imgeorgiev/SDP_G19_OfficeBot/Docs/sdp_new_environment_mockup.png

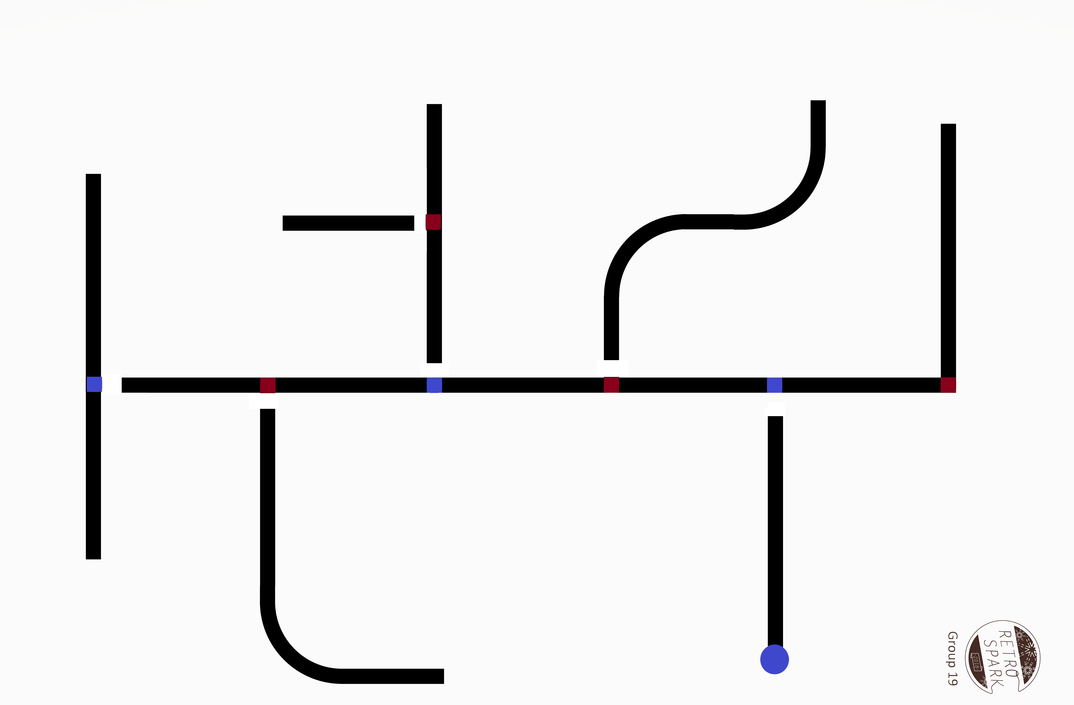
Docs/sdp_new_environment_mockup.png
