imgeorgiev/SDP_G19_OfficeBot/rpi/webapp/line2.jpg

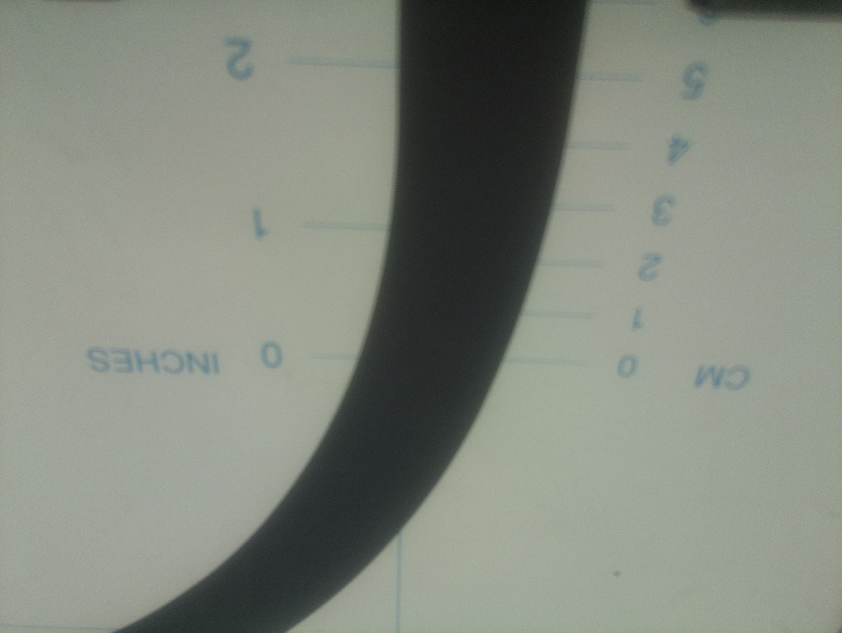
rpi/webapp/line2.jpg
