imgeorgiev/SDP_G19_OfficeBot/rpi/webapp/out.jpg

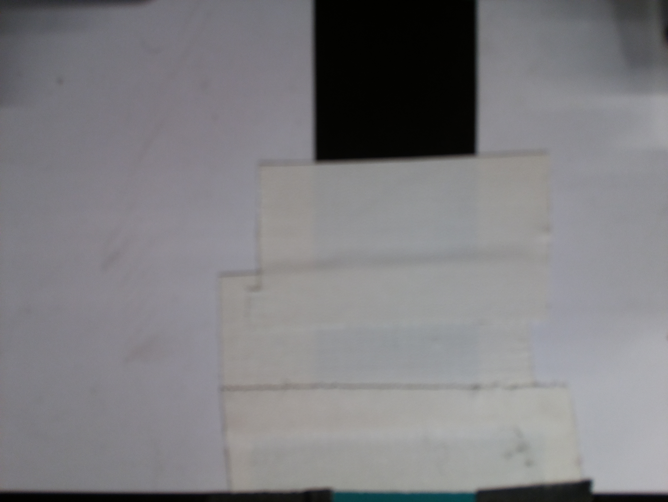
rpi/webapp/out.jpg
