imgeorgiev/SDP_G19_OfficeBot/rpi/webapp/paths2.jpg

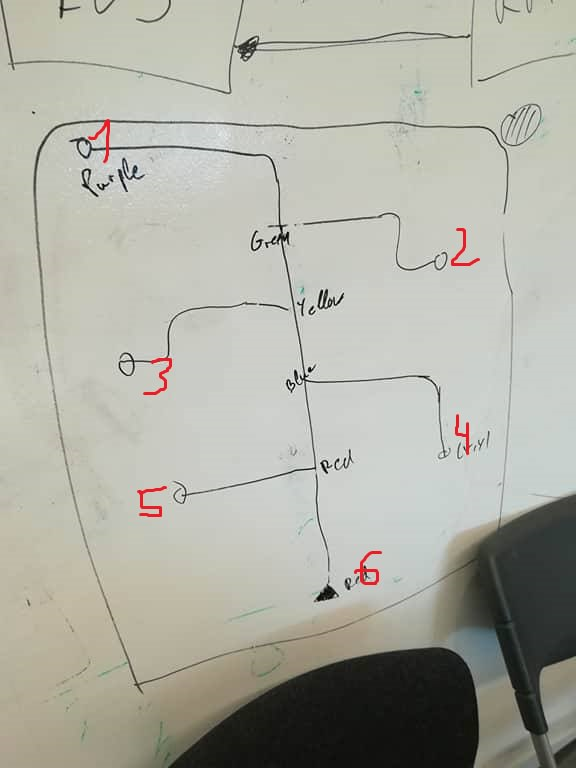
rpi/webapp/paths2.jpg
