imgeorgiev/SDP_G19_OfficeBot/rpi/webapp/paths2.png

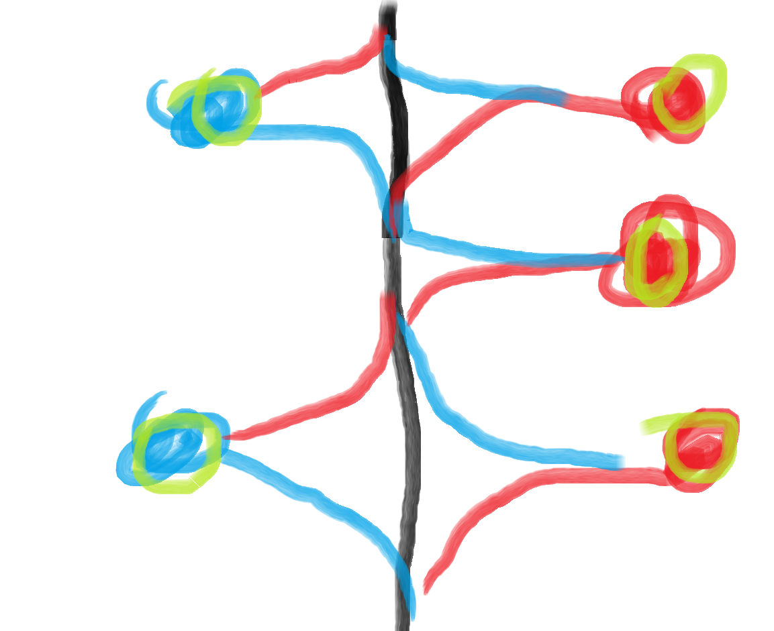
rpi/webapp/paths2.png
