imgeorgiev/SDP_G19_OfficeBot/rpi/webapp/paths.jpg

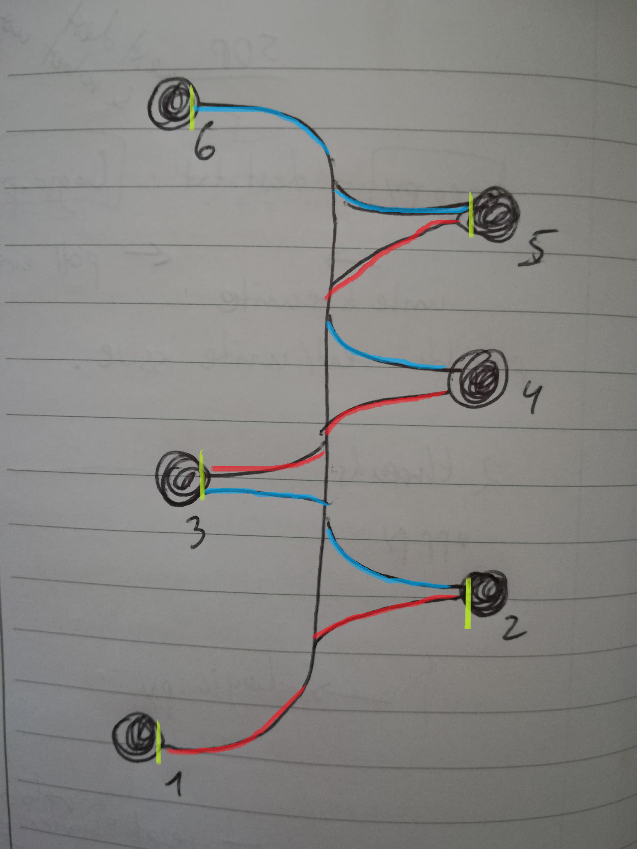
rpi/webapp/paths.jpg
