imgeorgiev/SDP_G19_OfficeBot/rpi/webapp/photos/blue.jpg

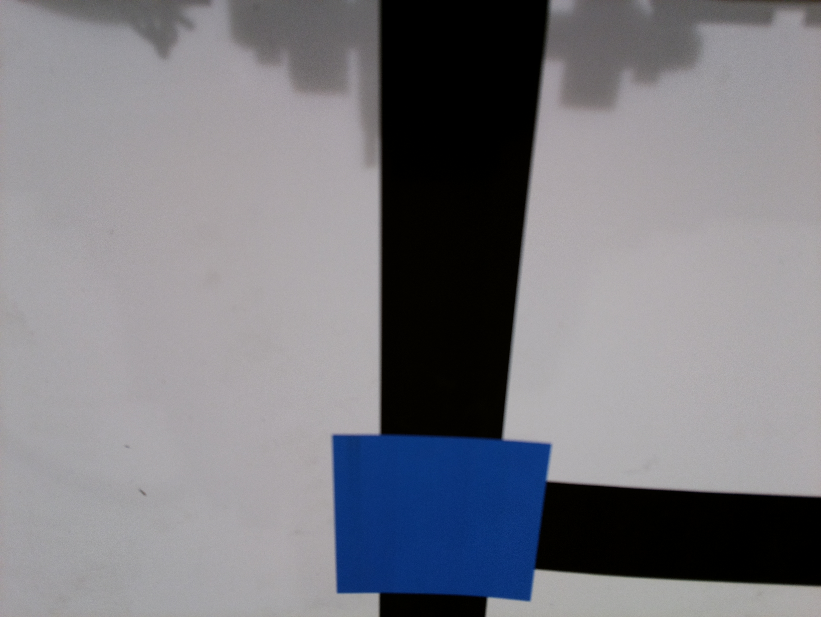
rpi/webapp/photos/blue.jpg
