imgeorgiev/SDP_G19_OfficeBot/rpi/webapp/photos/green.jpg

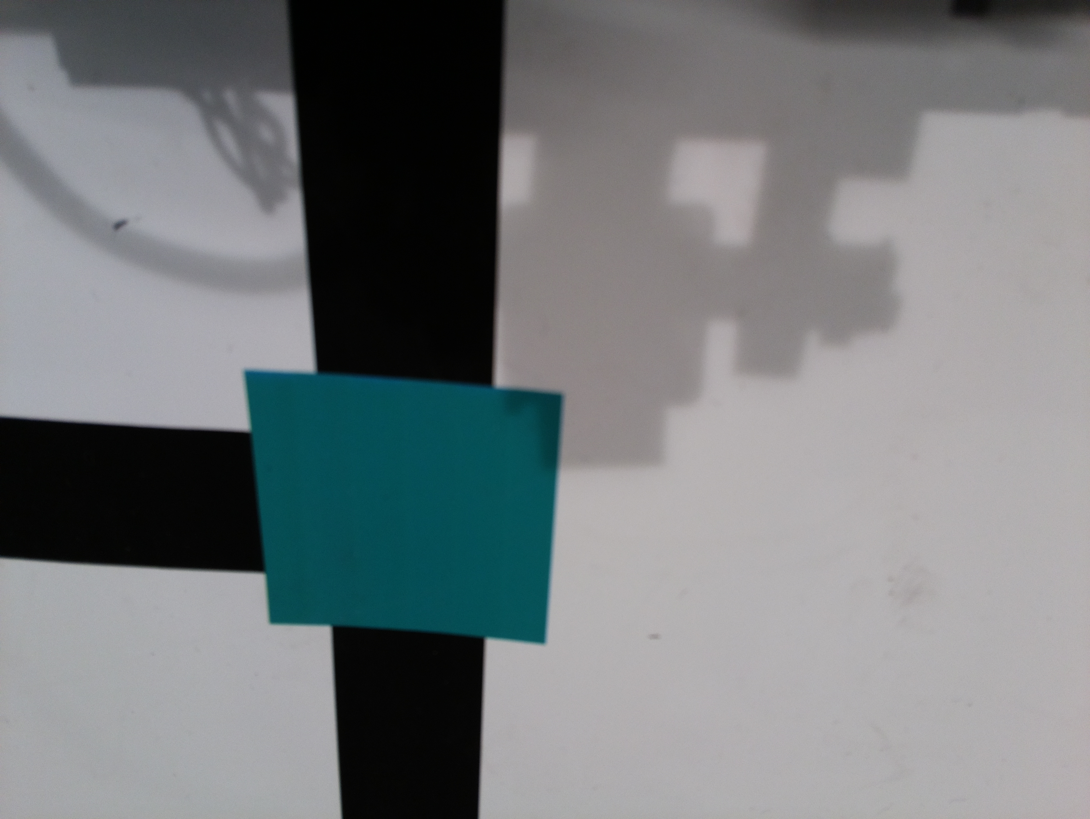
rpi/webapp/photos/green.jpg
