imgeorgiev/SDP_G19_OfficeBot/rpi/webapp/photos/grey.jpg

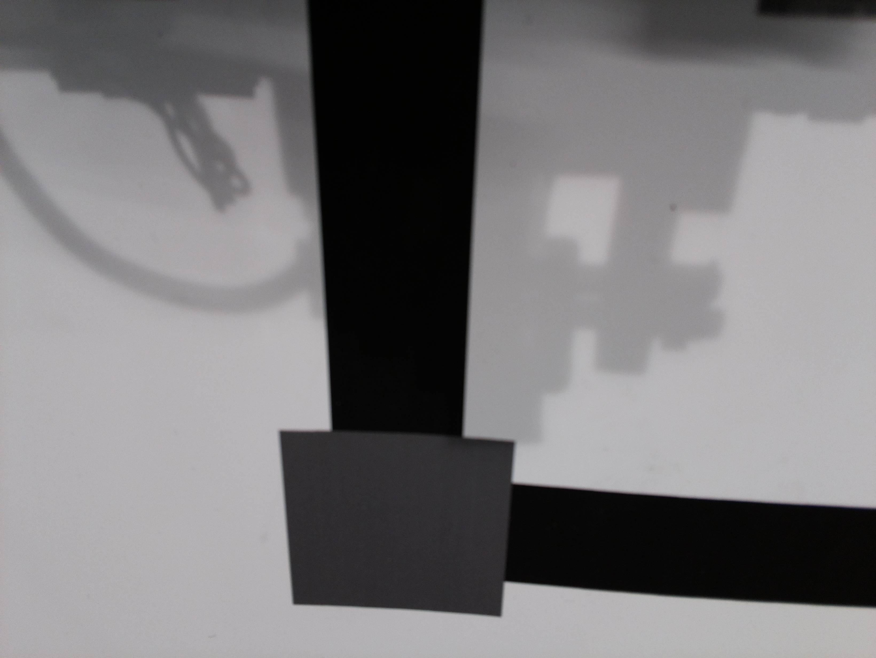
rpi/webapp/photos/grey.jpg
