imgeorgiev/SDP_G19_OfficeBot/rpi/webapp/photos/orange.jpg

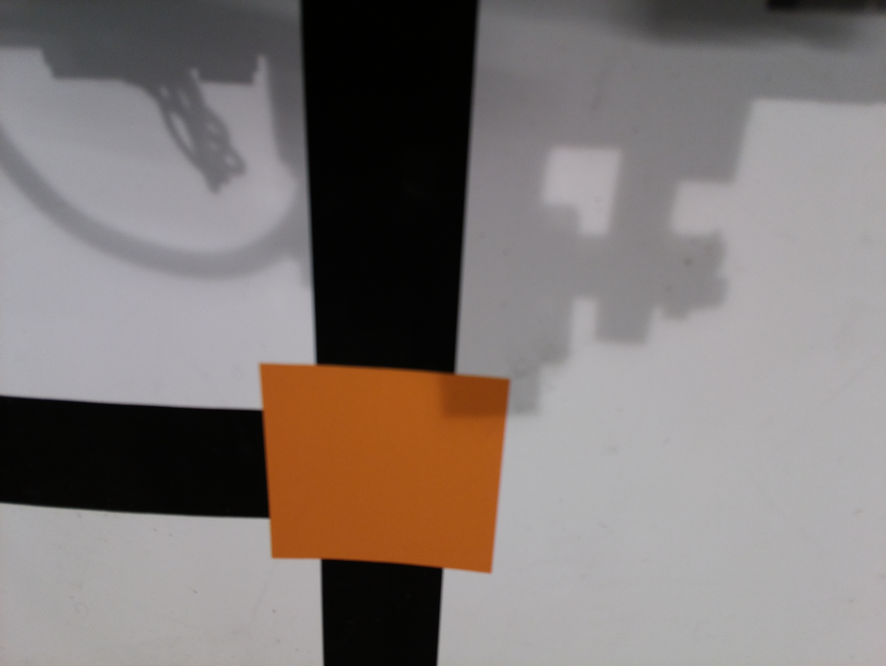
rpi/webapp/photos/orange.jpg
