imgeorgiev/SDP_G19_OfficeBot/rpi/webapp/photos/pink.jpg

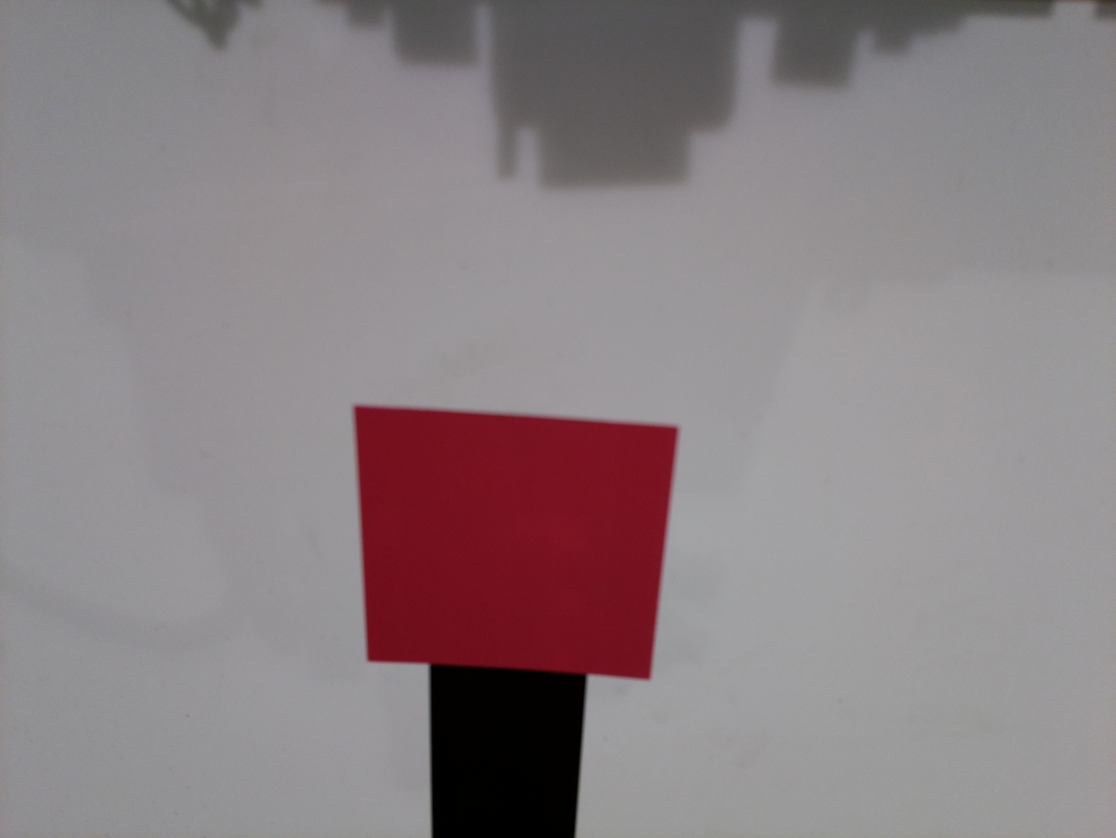
rpi/webapp/photos/pink.jpg
