imgeorgiev/SDP_G19_OfficeBot/rpi/webapp/photos/purple.jpg

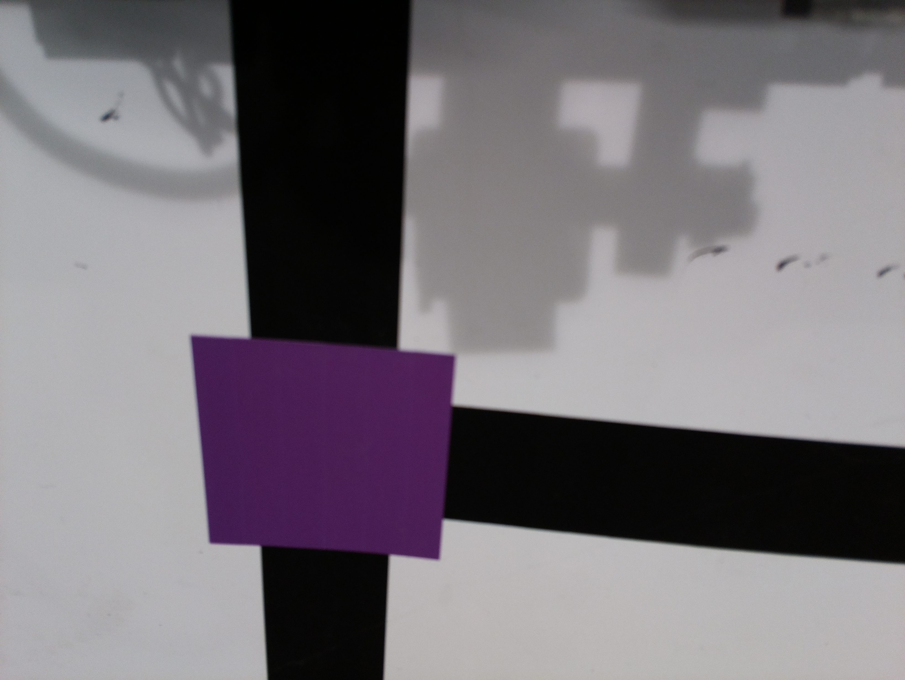
rpi/webapp/photos/purple.jpg
