imgeorgiev/SDP_G19_OfficeBot/rpi/webapp/photos/red.jpg

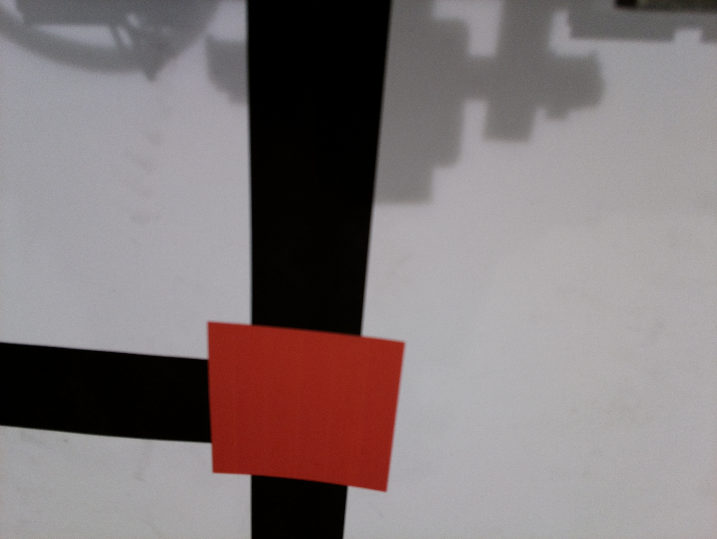
rpi/webapp/photos/red.jpg
