imgeorgiev/SDP_G19_OfficeBot/rpi/webapp/photos/yellow.jpg

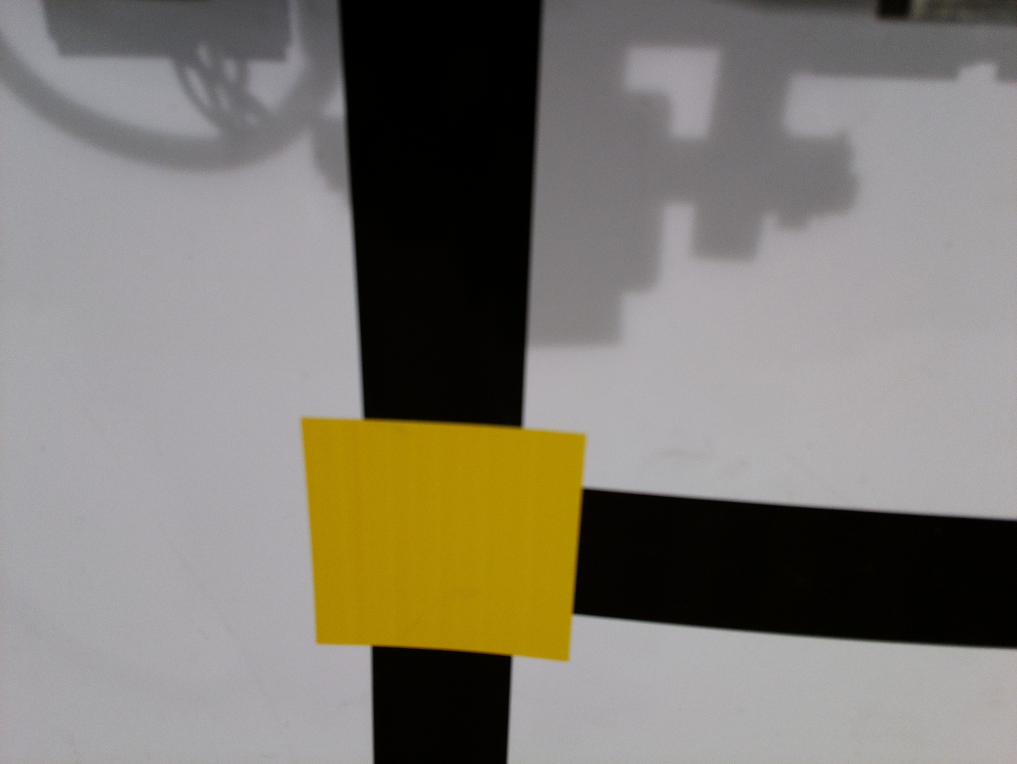
rpi/webapp/photos/yellow.jpg
