imgeorgiev/SDP_G19_OfficeBot/Docs/testing/sdp-IR.ods

Distance (cm) | Measurement
0 | 72
2 | 686
4 | 859
6 | 633
8 | 478
10 | 406
12 | 335
14 | 298
16 | 254
18 | 239
20 | 211
22 | 189
24 | 171
26 | 155
28 | 147
30 | 133
32 | 124
34 | 114
36 | 105
38 | 99
40 | 93
