imgeorgiev/SDP_G19_OfficeBot/Docs/testing/IR-measurements-graph.png

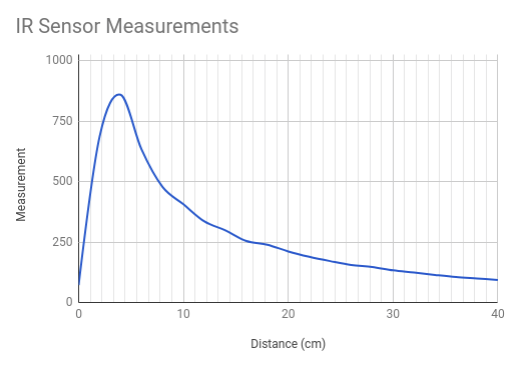
Docs/testing/IR-measurements-graph.png
