imgeorgiev/SDP_G19_OfficeBot/arduino/IR_sensors/IR_sensors.ino

// Reads 4 IR sensors and send out data through I2C to the bus master.

#include <Wire.h>

// function that executes whenever data is received from master
// this function is registered as an event, see setup()
long ir_1_val = 0;
long ir_2_val = 0;
long ir_3_val = 0;
long ir_4_val = 0;

// The setup routine runs once when you press reset:
void setup() {
  // Sets pin 13 for output in order to blink the LED:
  pinMode(A0, INPUT);
  pinMode(A2, INPUT);
  pinMode(A3, INPUT);
  pinMode(A4, INPUT);
  // Initialize serial communication at 9600 bits per second:

  Wire.begin(8);                // join i2c bus with address #8
  Wire.onReceive(requestEvent); // register event
  Serial.begin(9600);
}

// The loop routine runs over and over again forever:
void loop() {

  // Read the input on analog pin 0:
  int ir_1_val = analogRead(A0);
  int ir_2_val = analogRead(A1);
  int ir_3_val = analogRead(A2);
  int ur_4_val = analogRead(A3);

  // The "Mean" value will vary  the whole loop beacuse it isalways calculating the mean with the read values
  // The "Last Mean" value will only show the calculated mean value just to ease the reading of the calculated value
  Serial.print("IR 1 = ");
  Serial.println(ir_1_val);
  Serial.print("IR 2 = ");
  Serial.println(ir_2_val);
  Serial.print("IR 3 = ");
  Serial.println(ir_3_val);
  Serial.print("IR 4 = ");
  Serial.println(ir_4_val);
  delay(25);
}

// Write data to I2C bus
void requestEvent() {
  Wire.write(ir_1_val + ',' + ir_2_val + ',' + ir_3_val + ',' + ir_4_val + ';');
}
