imgeorgiev/SDP_G19_OfficeBot/(commit log)

2018-01-29 Added Arduino code for reading 4 IR sensors and transmitting their data through I2C TODO: Test comms from EV3 to Arduino I2C bus
2018-01-29 added the Arduino SDP library
2018-02-03 Fixes for if user supplies invalid URL.
    Display an error message if user edits the URL with:
    A desk number that doesn't exist.
    An action that doesn't exist.
    Also redirect 404s to homepage.
    Edited indentation to PEP8 standards.
    [app.py]
2018-02-05 Added serial read for the RPi fixed IR reader arduino code Everything tested and working
    [IR_sensors.ino]
2018-02-06 Added comments and increased stop distance
    Rearranged code in MotorThread and increased ultrasonic sensor distance.
2018-02-15 - reverted PS4 controls to working state - fixed Arduino IR code - added README how to set up the RPi as we are using it currently - fixed the serial read of the RPi
    [IR_sensors.ino, ps4_control.py, serial_class.py]
2018-02-15 bugfixes and readme update
    [serial_class.py]
2018-02-15 added currently_processing var
2018-02-15 added testing data for IR sensors fixed a bugs with IR data reader code
    [IR_data.csv, IR_data.ods]
2018-02-16 renamed logic_draft to logic, user cannot call x if logic is currently processing x
2018-02-19 initialized RPI branch
    [IR_data.csv, IR_data.ods]
2018-02-24 added battery testing data
    [battery.csv, battery.ods]
2018-02-26 converted tcp library to python3 fixed joystick issues changed format of motor commands
2018-02-26 Fixed issues with rpi TCP server added class for easy implimentation tweaked readme appropriately
    [tcpcom_py3.py]
2018-03-05 added new tcp parser without a class because the one with a class didn't work small bugfixes
    [parser.py]
2018-03-05 bugfixes and import changes
    [parser.py]
2018-03-05 parser fixes added tcp_test for basic fucntionality testing
    [parser.py, tcp_test.py]
2018-03-05 Added somewhat functional PID line follower
2018-03-05 Removed unnecessary threading. Added checking for junctions
2018-03-05 Removed unnecessary threading.
2018-03-08 added logic code for camera
2018-03-09 added pass statements to camera code to compile
2018-03-09 [CHANGE PATH] added small fixes
    [logic.py]
2018-03-12 fixed syntax errors in logic.py
    [logic.py]
2018-03-12 file pinging doesn't happen every while cycle (mod value not tested)
    [logic.py]
2018-03-12 fixed cirle -> circle typo
    [logic.py]
2018-03-12 Added gear ratio
2018-03-12 small typo fix logic.py
    [logic.py]
2018-03-12 library update and bugfixes added testing file to test the TCP connection
    [tcp_test.py, tcpcom_py3.py]
2018-03-12 Moved main logic into onStateChanged, removed color sensors
2018-03-12 fixed issues with the parser not working
    [parser.py]
2018-03-12 fixed the tcpcom library
    [tcp_test.py, tcpcom_py3.py]
2018-03-12 cleaned tcp libraries and fixed the python3 one
    [tcpcom_py3.py]
2018-03-13 destination and position no longer global variables
    [logic.py]
2018-03-13 Fixed bug where distance_Green used readFrame rather than HSV_green
    [logic.py]
2018-03-13 fixed turn method's run_to_rel_pos
    [parser.py]
2018-03-14 added camera pip installs to README.md
2018-03-14 replaced if-elif in line_following with array of weights
    [logic.py]
2018-03-14 Replaced image_red, image_black... with dictionary with colors as keys
    [logic.py]
2018-03-15 extracted printLinesToScreen method, made line global
2018-03-15 removed hardcoded path for tcp_rpi and replaced file_ping with sleep
    [logic.py]
2018-03-15 renamed frame
2018-03-15 Reverse if no line is detected
    [logic.py]
2018-03-15 made method to reset dictionary
    [logic.py]
2018-03-16 Fixed isStartingColor and isDestColor always returning true
    [logic.py]
2018-03-16 Fixed list out of bounds and speed not being int exceptions
    [logic.py]
2018-03-16 Set motor speed to 0 when reaching destination
2018-03-16 removed redundant sys library, various pep8 fixes
    [logic.py]
2018-03-17 only send motor commands if the speeds change
2018-03-17 replaced various lists with tuples
    [logic.py]
2018-03-17 fixed printLinesToScreen for one argument
    [logic.py]
2018-03-19 add Camera warmup
2018-03-19 fix yellow does not work
    [logic.py]
2018-03-19 reverted change to relative import
    [logic.py]
2018-03-21 test camera image
2018-03-21 initial swap camera for picamera
    [logic.py]
2018-03-22 print when turning
2018-03-22 print time for each loop
2018-03-22 fix priority scheduling for when checking file
    [app.py]
2018-03-28 fix listerror and integererrors
    [logic.py]
2018-03-28 print colors in compute path
2018-03-28 fix for new color detect
    [logic.py]
2018-03-29 Fixed reconnection issue of EV3 TCP Refactored code and added thread killing Added voice commands to the TCP library Added a startup script for launching the EV3 TCP parser externally
    [parser.py, tcp_test.py, tcpcom_py3.py]
2018-04-01 removed unnecessary threading, added turn ratio scaling
2018-04-01 comment out print statements and re-add threading cleanup
2018-04-01 Added ir sensor method stub, removed setting previous line speeds
2018-04-01 added print statement when something is close
2018-04-01 made ir_reader use threading
2018-04-01 Send speak command when arriving and departing, stop while something close to sensors
2018-04-01 fixed int->str not being converted
    [logic.py]
2018-04-01 fixed PS4 importing issues
    [logic.py]
2018-04-01 move waitKey to printLinesToScreen
2018-04-01 fixed turn being the wrong direction
    [logic.py]
2018-04-01 commented out code for printing to screen, added comments
2018-04-01 Fix houghCicles bug from 5436f0bae
    [logic.py]
2018-04-01 turn about one wheel
2018-04-01 only send motor commands when speeds change
2018-04-01 reset previousWheelSpeed when something in the way
    [logic.py]
2018-04-02 final bugfixes on webapp and pscontrol
    [app.py, logic.py, psControl.py]
2018-04-02 Fixed thresholdContours, increase turn to 100
    [logic.py]
2018-04-02 fixed L/R wheels being inverted
    [logic.py]
2018-09-02 commtting documentation
    [sdp-IR.ods, sdp-IR.xlsx]
2018-09-02 added documentation added a project overview added the arduino source code
